Mark-MDO47/ArduinoWS2812bClock/images/LED_241_Dimensions.jpg

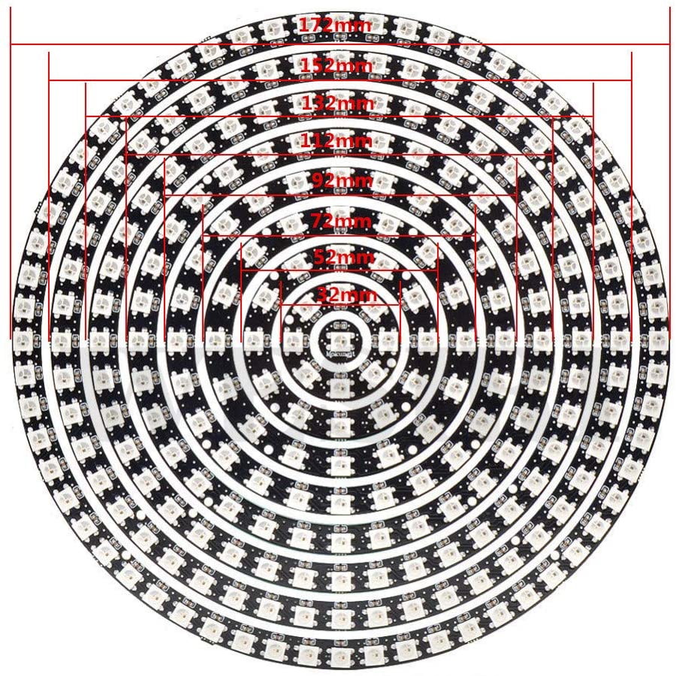
images/LED_241_Dimensions.jpg
