Mark-MDO47/ArduinoWS2812bClock/images/LED_241_busPower.jpg

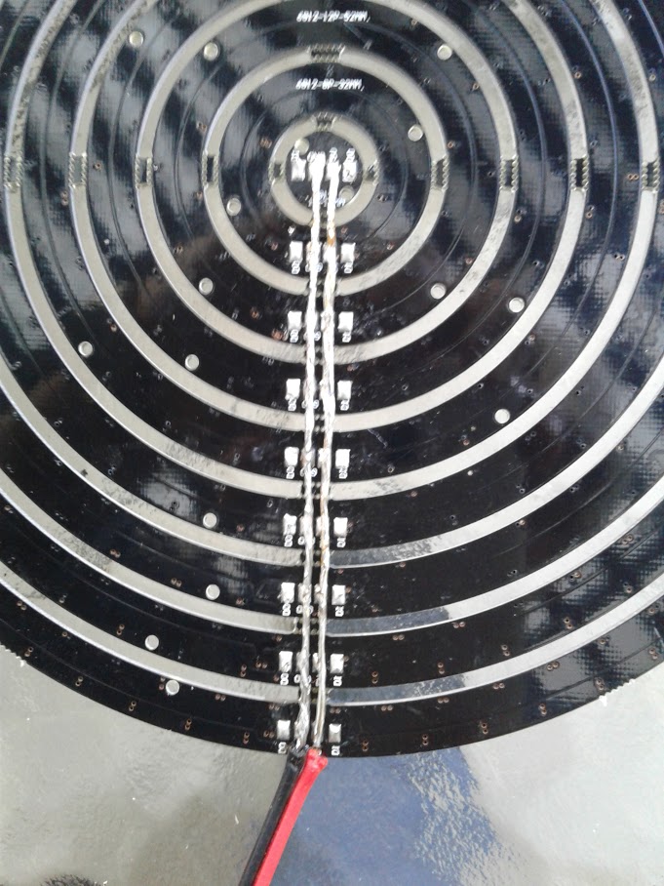
images/LED_241_busPower.jpg
