Mark-MDO47/ArduinoWS2812bClock/PartsListESP32Clock.xlsx

Sheet: PartsList
Num | CostEach | CostTotal | Description | Source | | Num | CostEach | CostTotal | Description | Source | | Ordering
Num | CostEach | CostTotal | Description | Source | | --- | --- | --- | --- | --- | | Price | Qty
1 | $29.99 | $29.99 | 241 LEDs 9 Rings WS2812B 5050 RGB LED | https://smile.amazon.com/gp/product/B083VWVP3J/ | | 1 | $29.99 | $29.99 | 241 LEDs 9 Rings WS2812B 5050 RGB LED | https://smile.amazon.com/gp/product/B083VWVP3J/ | | $29.99 | 1
1 | $5.16 | $5.16 | ESP32 ESP-32S CP2102 NodeMCU-32S ESP-WROOM-32 WiFi Unassembled | https://smile.amazon.com/gp/product/B08DQQ8CBP/ | | 1 | $5.16 | $5.16 | ESP32 ESP-32S CP2102 NodeMCU-32S ESP-WROOM-32 WiFi Unassembled | https://smile.amazon.com/gp/product/B08DQQ8CBP/ | | $25.79 | 5
0 | $6.00 | $0.00 | ESP32 ESP-32S CP2102 NodeMCU-32S ESP-WROOM-32 WiFi | https://smile.amazon.com/DORHEA-Development-Microcontroller-NodeMCU-32S-ESP-WROOM-32/dp/B086MJGFVV/ | | 0 | $6.00 | $0.00 | ESP32 ESP-32S CP2102 NodeMCU-32S ESP-WROOM-32 WiFi | https://smile.amazon.com/DORHEA-Development-Microcontroller-NodeMCU-32S-ESP-WROOM-32/dp/B086MJGFVV/ | | $17.99 | 3
1 | $0.40 | $0.40 | SN74HCT125N quadruple bus buffer and voltage translator | https://www.digikey.com/product-detail/en/texas-instruments/SN74HCT125N/296-8386-5-ND/376860 | | 1 | $0.40 | $0.40 | SN74HCT125N quadruple bus buffer and voltage translator | https://www.digikey.com/product-detail/en/texas-instruments/SN74HCT125N/296-8386-5-ND/376860 | | $0.40 | 1
1 | $4.45 | $4.45 | UBEC 3Amp | https://smile.amazon.com/2-Pieces-Hobbywing-Switch-mode-UBEC-Helicopter-Quadcopter/dp/B01GHMW0C0 | | 1 | $4.45 | $4.45 | UBEC 3Amp | https://smile.amazon.com/2-Pieces-Hobbywing-Switch-mode-UBEC-Helicopter-Quadcopter/dp/B01GHMW0C0 | | $8.90 | 2
1 | $0.10 | $0.10 | 220 Ohm resistor, 1/4 watt (optional) | https://www.digikey.com/en/products/detail/stackpole-electronics-inc/CF14JT220R/1741346 | | 1 | $0.10 | $0.10 | 220 Ohm resistor, 1/4 watt (optional) | https://www.digikey.com/en/products/detail/stackpole-electronics-inc/CF14JT220R/1741346 | | $0.10 | 1
1 | $0.10 | $0.10 | 10K Ohm resistor, 1/4 watt | https://www.digikey.com/en/products/detail/stackpole-electronics-inc/CF14JT10K0/1741265 | | 1 | $0.10 | $0.10 | 10K Ohm resistor, 1/4 watt | https://www.digikey.com/en/products/detail/stackpole-electronics-inc/CF14JT10K0/1741265 | | $0.10 | 1
1 | $0.10 | $0.10 | 0.1 uF electrolytic capacitor | https://www.digikey.com/en/products/detail/w%C3%BCrth-elektronik/860010672001/5728608 | | 1 | $0.10 | $0.10 | 0.1 uF electrolytic capacitor | https://www.digikey.com/en/products/detail/w%C3%BCrth-elektronik/860010672001/5728608 | | $0.10 | 1
1 | $0.53 | $0.53 | 100 uF electrolytic capacitor | https://www.digikey.com/en/products/detail/panasonic-electronic-components/ECA-2AM101/245067 | | 1 | $0.53 | $0.53 | 100 uF electrolytic capacitor | https://www.digikey.com/en/products/detail/panasonic-electronic-components/ECA-2AM101/245067 | | $0.53 | 1

Sheet: ByHand
 |  |  |  |  |  |  |  |  |  |  |  |  |  |  |  |  |  |  |  | 0 | 1 | 2 | 3 | 4 | 5 | 6 | 7 | 8 |  |  |  |  |  |  |  |  |  |  |  |  |  |  |  |  |  |  |  |  | 0 | 1
idx | 0 | 1 | 2 | 3 | 4 | 5 | 6 | 7 | 8 | idx | 0 | 1 | 2 | 3 | 4 | 5 | 6 | 7 | 8 | { | { | { | { | { | { | { | { | { | idx | 0 | 1 | 2 | 3 | 4 | 5 | 6 | 7 | 8 | idx | 0 | 1 | 2 | 3 | 4 | 5 | 6 | 7 | 8 | { | {
0 |  |  |  |  |  |  |  |  |  | 0 | 0 | 0 | 0 | 0 | 0 | 0 | 0 | 0 | 0 | { 0, | { 0, | { 0, | { 0, | { 0, | { 0, | { 0, | { 0, | { 0, | 0 |  |  |  |  |  |  |  |  |  | 0 | 0 | 0 | 0 | 0 | 0 | 0 | 0 | 0 | 0 | { 0, | { 0,
1 | 1 |  |  |  |  |  |  |  |  | 1 | 1 | 0 | 0 | 0 | 0 | 0 | 0 | 0 | 0 | { 0, 1, | { 0, 0, | { 0, 0, | { 0, 0, | { 0, 0, | { 0, 0, | { 0, 0, | { 0, 0, | { 0, 0, | 1 | 1 | 1 | 1 | 1 | 1 | 1 | 1 | 1 |  | 1 | 1 | 1 | 1 | 1 | 1 | 1 | 1 | 1 | 0 | { 0, 1, | { 0, 1,
2 | 1 | 1 |  |  |  |  |  |  |  | 2 | 2 | 1 | 0 | 0 | 0 | 0 | 0 | 0 | 0 | { 0, 1, 2, | { 0, 0, 1, | { 0, 0, 0, | { 0, 0, 0, | { 0, 0, 0, | { 0, 0, 0, | { 0, 0, 0, | { 0, 0, 0, | { 0, 0, 0, | 2 | 1 | 1 | 1 | 1 | 1 |  |  |  |  | 2 | 2 | 2 | 2 | 2 | 2 | 1 | 1 | 1 | 0 | { 0, 1, 2, | { 0, 1, 2,
3 | 1 | 1 | 1 |  |  |  |  |  |  | 3 | 3 | 2 | 1 | 0 | 0 | 0 | 0 | 0 | 0 | { 0, 1, 2, 3, | { 0, 0, 1, 2, | { 0, 0, 0, 1, | { 0, 0, 0, 0, | { 0, 0, 0, 0, | { 0, 0, 0, 0, | { 0, 0, 0, 0, | { 0, 0, 0, 0, | { 0, 0, 0, 0, | 3 | 1 | 1 | 1 | 1 |  |  |  |  |  | 3 | 3 | 3 | 3 | 3 | 2 | 1 | 1 | 1 | 0 | { 0, 1, 2, 3, | { 0, 1, 2, 3,
4 | 1 | 1 | 1 | 1 |  |  |  |  |  | 4 | 4 | 3 | 2 | 1 | 0 | 0 | 0 | 0 | 0 | { 0, 1, 2, 3, 4, | { 0, 0, 1, 2, 3, | { 0, 0, 0, 1, 2, | { 0, 0, 0, 0, 1, | { 0, 0, 0, 0, 0, | { 0, 0, 0, 0, 0, | { 0, 0, 0, 0, 0, | { 0, 0, 0, 0, 0, | { 0, 0, 0, 0, 0, | 4 | 1 | 1 | 1 |  |  |  |  |  |  | 4 | 4 | 4 | 4 | 3 | 2 | 1 | 1 | 1 | 0 | { 0, 1, 2, 3, 4, | { 0, 1, 2, 3, 4,
5 | 1 | 1 | 1 | 1 | 1 |  |  |  |  | 5 | 5 | 4 | 3 | 2 | 1 | 0 | 0 | 0 | 0 | { 0, 1, 2, 3, 4, 5, | { 0, 0, 1, 2, 3, 4, | { 0, 0, 0, 1, 2, 3, | { 0, 0, 0, 0, 1, 2, | { 0, 0, 0, 0, 0, 1, | { 0, 0, 0, 0, 0, 0, | { 0, 0, 0, 0, 0, 0, | { 0, 0, 0, 0, 0, 0, | { 0, 0, 0, 0, 0, 0, | 5 | 1 |  |  |  |  |  |  |  |  | 5 | 5 | 4 | 4 | 3 | 2 | 1 | 1 | 1 | 0 | { 0, 1, 2, 3, 4, 5, | { 0, 1, 2, 3, 4, 4,
6 | 1 | 1 | 1 | 1 | 1 | 1 |  |  |  | 6 | 6 | 5 | 4 | 3 | 2 | 1 | 0 | 0 | 0 | { 0, 1, 2, 3, 4, 5, 6, | { 0, 0, 1, 2, 3, 4, 5, | { 0, 0, 0, 1, 2, 3, 4, | { 0, 0, 0, 0, 1, 2, 3, | { 0, 0, 0, 0, 0, 1, 2, | { 0, 0, 0, 0, 0, 0, 1, | { 0, 0, 0, 0, 0, 0, 0, | { 0, 0, 0, 0, 0, 0, 0, | { 0, 0, 0, 0, 0, 0, 0, | 6 | 1 | 1 |  |  |  |  |  |  |  | 6 | 6 | 5 | 4 | 3 | 2 | 1 | 1 | 1 | 0 | { 0, 1, 2, 3, 4, 5, 6, | { 0, 1, 2, 3, 4, 4, 5,
7 | 1 |  |  |  |  |  |  |  |  | 7 | 7 | 5 | 4 | 3 | 2 | 1 | 0 | 0 | 0 | { 0, 1, 2, 3, 4, 5, 6, 7, | { 0, 0, 1, 2, 3, 4, 5, 5, | { 0, 0, 0, 1, 2, 3, 4, 4, | { 0, 0, 0, 0, 1, 2, 3, 3, | { 0, 0, 0, 0, 0, 1, 2, 2, | { 0, 0, 0, 0, 0, 0, 1, 1, | { 0, 0, 0, 0, 0, 0, 0, 0, | { 0, 0, 0, 0, 0, 0, 0, 0, | { 0, 0, 0, 0, 0, 0, 0, 0, | 7 | 1 | 1 | 1 | 1 | 1 | 1 |  |  |  | 7 | 7 | 6 | 5 | 4 | 3 | 2 | 1 | 1 | 0 | { 0, 1, 2, 3, 4, 5, 6, 7, | { 0, 1, 2, 3, 4, 4, 5, 6,
8 | 1 | 1 | 1 | 1 | 1 | 1 | 1 | 1 |  | 8 | 8 | 6 | 5 | 4 | 3 | 2 | 1 | 1 | 0 | { 0, 1, 2, 3, 4, 5, 6, 7, 8, | { 0, 0, 1, 2, 3, 4, 5, 5, 6, | { 0, 0, 0, 1, 2, 3, 4, 4, 5, | { 0, 0, 0, 0, 1, 2, 3, 3, 4, | { 0, 0, 0, 0, 0, 1, 2, 2, 3, | { 0, 0, 0, 0, 0, 0, 1, 1, 2, | { 0, 0, 0, 0, 0, 0, 0, 0, 1, | { 0, 0, 0, 0, 0, 0, 0, 0, 1, | { 0, 0, 0, 0, 0, 0, 0, 0, 0, | 8 | 1 |  |  |  |  |  | 1 |  |  | 8 | 8 | 6 | 5 | 4 | 3 | 2 | 2 | 1 | 0 | { 0, 1, 2, 3, 4, 5, 6, 7, 8, | { 0, 1, 2, 3, 4, 4, 5, 6, 6,
9 | 1 | 1 |  |  |  |  | 1 |  |  | 9 | 9 | 7 | 5 | 4 | 3 | 2 | 2 | 1 | 0 | { 0, 1, 2, 3, 4, 5, 6, 7, 8, 9, | { 0, 0, 1, 2, 3, 4, 5, 5, 6, 7, | { 0, 0, 0, 1, 2, 3, 4, 4, 5, 5, | { 0, 0, 0, 0, 1, 2, 3, 3, 4, 4, | { 0, 0, 0, 0, 0, 1, 2, 2, 3, 3, | { 0, 0, 0, 0, 0, 0, 1, 1, 2, 2, | { 0, 0, 0, 0, 0, 0, 0, 0, 1, 2, | { 0, 0, 0, 0, 0, 0, 0, 0, 1, 1, | { 0, 0, 0, 0, 0, 0, 0, 0, 0, 0, | 9 | 1 | 1 | 1 | 1 | 1 | 1 |  |  |  | 9 | 9 | 7 | 6 | 5 | 4 | 3 | 2 | 1 | 0 | { 0, 1, 2, 3, 4, 5, 6, 7, 8, 9, | { 0, 1, 2, 3, 4, 4, 5, 6, 6, 7,
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

Sheet: Ring Calcs
Best FastLED pin(s) to use with ESP32? | fastpin_esp32.h (https://github.com/FastLED/FastLED/blob/8ac3dd7f00e933a376530ecf86d360d167e1b82a/platforms/esp/32/fastpin_esp32.h) | https://www.reddit.com/r/FastLED/comments/gpu1fv/best_pins_to_use_with_esp32/ | Third, note that all boards are different. On the Espressif PICO-D4 boards that I favor, pin 12 seems to be used for flash boot. On my board, 13, 14, 15, 18, 19, 23, 25, 26 are all good for LEDs.
start_per_ring | leds_per_ringqrtr | leds_per_ring | factors
0 | 15 | 60 |  |  |  | 2 | 2 | 3 | 5
60 | 12 | 48 |  | 2 | 2 | 2 | 2 | 3
108 | 10 | 40 |  |  | 2 | 2 | 2 |  | 5
148 | 8 | 32 | 2 | 2 | 2 | 2 | 2 |  |  |  |  | 96
180 | 6 | 24 |  |  | 2 | 2 | 2 | 3
204 | 4 | 16 |  | 2 | 2 | 2 | 2
220 | 3 | 12 |  |  |  | 2 | 2 | 3
232 | 2 | 8 |  |  | 2 | 2 | 2
240 | 1 | 1
 |  |  |  | 1
 |  |  | 2 | 2
 |  |  | 2 | 4
 |  |  | 2 | 8
 |  |  | 2 | 16
 |  |  | 2 | 32
 |  |  | 3 | 96
 |  |  | 5 | 480 |  | #define LCM_LEDS_PER_RING 480 // they all divide into 480 evenly (least common multiple)
 |  |  | 60 | 48 | 40 | 32 | 24 | 16 | 12 | 8 | 1 |  | leds_per_ring[NUM_RINGS_PER_DISK]
 |  |  | 0 | 60 | 108 | 148 | 180 | 204 | 220 | 232 | 240 |  | start_per_ring[NUM_RINGS_PER_DISK]
 |  |  | 15 | 12 | 10 | 8 | 6 | 4 | 3 | 2 | 1 |  | leds_per_ringqrtr[NUM_RINGS_PER_DISK]

Sheet: RadarCalcs
#define NUM_LEDS_PER_DISK 241 |  |  |  |  |  |  |  |  | hour | min | angle-sec | deg
#define NUM_RINGS_PER_DISK 9 |  |  |  |  |  |  |  |  | 12 | 15 | 1 | 6
#define MAX_LEDS_PER_RING 60 |  |  |  |  |  |  |  |  | 12 | 30 | 3 | 18
#define MIN_LEDS_PER_RING 1 |  |  |  |  |  |  |  |  | 12 | 45 | 4 | 24
 |  |  |  |  |  |  |  |  | 1 | 0 | 5 | 30
 |  |  |  |  |  |  |  |  | 11 | 59 | 60 | 360
 |  |  |  |  |  |  |  |  | 12 | 0 | 0 | 0
const uint16_t leds_per_ring[NUM_RINGS_PER_DISK] = { MAX_LEDS_PER_RING, 48, 40, 32, 24, 16, 12, 8, MIN_LEDS_PER_RING }; // MAX_LEDS_PER_RING = 60
const uint16_t leds_per_ringqrtr[NUM_RINGS_PER_DISK] = { 15, 12, 10, 8, 6, 4, 3, 2, 1 };
const uint16_t start_per_ring[NUM_RINGS_PER_DISK] = { 0, 60, 108, 148, 180, 204, 220, 232, 240 }; // which LED index is the start of each ring
static int8_t this_ring = 0; // from ring_9 (value 0, outer ring) to ring_1 (value 8, inner ring (one LED))
static int8_t this_qrtr = 0; // from qrtr_1 (value 0) to qrtr_4 (value 3), count modulo in either direction
uint32_t radar_xray_bitmask[(NUM_LEDS_PER_DISK+31)/32]; // bitmask where X-Ray LEDs are for STEP2_RADAR_XRAY_SHDW1; >= one bit per LED per ring
static uint32_t bitmsk32; // used to pick out the bit in radar_xray_bitmask
static uint8_t idx_bitmsk32; // index to which array member for radar_xray_bitmask
 |  |  |  |  | ring | 0 | 1 | 2 | 3 | 4 | 5 | 6 | 7 | 8 | start_per_ring | 0 | 60 | 108 | 148 | 180 | 204 | 220 | 232 | 240
 | tmp_idx | radar_adv_per_LED_per_ring | start_per_ring | leds_per_ring | leds_per_ring | 60 | 48 | 40 | 32 | 24 | 16 | 12 | 8 | 1
 | 0 |  | 0 | 60 |  | idx_r0 | idx_r1 | idx_r2 | idx_r3 | idx_r4 | idx_r5 | idx_r6 | idx_r7 | idx_r8
 | 1 |  | 60 | 48 |  | 0 | 0 | 0 | 0 | 0 | 0 | 0 | 0 | 0
 | 2 |  | 108 | 40 |  | 1 | 1 | 1 | 1 | 0 | 0 | 0 | 0 | 0
 | 3 | 0 | 148 | 32 |  | 2 | 2 | 1 | 1 | 1 | 1 | 0 | 0 | 0
 | 4 | 192 | 180 | 24 |  | 3 | 2 | 2 | 2 | 1 | 1 | 1 | 0 | 0
 | 5 | 128 | 204 | 16 |  | 4 | 3 | 3 | 2 | 2 | 1 | 1 | 1 | 0
 | 6 | 96 | 220 | 12 |  | 5 | 4 | 3 | 3 | 2 | 1 | 1 | 1 | 0
 | 7 | 64 | 232 | 8 |  | 6 | 5 | 4 | 3 | 2 | 2 | 1 | 1 | 0
 | 8 | 0 | 240 | 1 |  | 7 | 6 | 5 | 4 | 3 | 2 | 1 | 1 | 0
 |  |  |  |  |  | 8 | 6 | 5 | 4 | 3 | 2 | 2 | 1 | 0
 |  |  |  |  |  | 9 | 7 | 6 | 5 | 4 | 2 | 2 | 1 | 0
 |  |  |  |  |  | 10 | 8 | 7 | 5 | 4 | 3 | 2 | 1 | 0
 |  |  |  |  |  | 11 | 9 | 7 | 6 | 4 | 3 | 2 | 1 | 0
 |  |  |  |  |  | 12 | 10 | 8 | 6 | 5 | 3 | 2 | 2 | 0
 |  |  |  |  |  | 13 | 10 | 9 | 7 | 5 | 3 | 3 | 2 | 0
 |  |  |  |  |  | 14 | 11 | 9 | 7 | 6 | 4 | 3 | 2 | 0
 |  |  |  |  |  | 15 | 12 | 10 | 8 | 6 | 4 | 3 | 2 | 0
 |  |  |  |  |  | 16 | 13 | 11 | 9 | 6 | 4 | 3 | 2 | 0
 |  |  |  |  |  | 17 | 14 | 11 | 9 | 7 | 5 | 3 | 2 | 0
 |  |  |  |  |  | 18 | 14 | 12 | 10 | 7 | 5 | 4 | 2 | 0
 |  |  |  |  |  | 19 | 15 | 13 | 10 | 8 | 5 | 4 | 3 | 0
 |  |  |  |  |  | 20 | 16 | 13 | 11 | 8 | 5 | 4 | 3 | 0
 |  |  |  |  |  | 21 | 17 | 14 | 11 | 8 | 6 | 4 | 3 | 0
 |  |  |  |  |  | 22 | 18 | 15 | 12 | 9 | 6 | 4 | 3 | 0
 |  |  |  |  |  | 23 | 18 | 15 | 12 | 9 | 6 | 5 | 3 | 0
 |  |  |  |  |  | 24 | 19 | 16 | 13 | 10 | 6 | 5 | 3 | 0
 |  |  |  |  |  | 25 | 20 | 17 | 13 | 10 | 7 | 5 | 3 | 0
 |  |  |  |  |  | 26 | 21 | 17 | 14 | 10 | 7 | 5 | 3 | 0
 |  |  |  |  |  | 27 | 22 | 18 | 14 | 11 | 7 | 5 | 4 | 0
 |  |  |  |  |  | 28 | 22 | 19 | 15 | 11 | 7 | 6 | 4 | 0
 |  |  |  |  |  | 29 | 23 | 19 | 15 | 12 | 8 | 6 | 4 | 0
 |  |  |  |  |  | 30 | 24 | 20 | 16 | 12 | 8 | 6 | 4 | 0
 |  |  |  |  |  | 31 | 25 | 21 | 17 | 12 | 8 | 6 | 4 | 0
 |  |  |  |  |  | 32 | 26 | 21 | 17 | 13 | 9 | 6 | 4 | 0
 |  |  |  |  |  | 33 | 26 | 22 | 18 | 13 | 9 | 7 | 4 | 0
 |  |  |  |  |  | 34 | 27 | 23 | 18 | 14 | 9 | 7 | 5 | 0
 |  |  |  |  |  | 35 | 28 | 23 | 19 | 14 | 9 | 7 | 5 | 0
 |  |  |  |  |  | 36 | 29 | 24 | 19 | 14 | 10 | 7 | 5 | 0
 |  |  |  |  |  | 37 | 30 | 25 | 20 | 15 | 10 | 7 | 5 | 0
 |  |  |  |  |  | 38 | 30 | 25 | 20 | 15 | 10 | 8 | 5 | 0
 |  |  |  |  |  | 39 | 31 | 26 | 21 | 16 | 10 | 8 | 5 | 0
 |  |  |  |  |  | 40 | 32 | 27 | 21 | 16 | 11 | 8 | 5 | 0
 |  |  |  |  |  | 41 | 33 | 27 | 22 | 16 | 11 | 8 | 5 | 0
 |  |  |  |  |  | 42 | 34 | 28 | 22 | 17 | 11 | 8 | 6 | 0
 |  |  |  |  |  | 43 | 34 | 29 | 23 | 17 | 11 | 9 | 6 | 0
 |  |  |  |  |  | 44 | 35 | 29 | 23 | 18 | 12 | 9 | 6 | 0
 |  |  |  |  |  | 45 | 36 | 30 | 24 | 18 | 12 | 9 | 6 | 0
 |  |  |  |  |  | 46 | 37 | 31 | 25 | 18 | 12 | 9 | 6 | 0
 |  |  |  |  |  | 47 | 38 | 31 | 25 | 19 | 13 | 9 | 6 | 0
 |  |  |  |  |  | 48 | 38 | 32 | 26 | 19 | 13 | 10 | 6 | 0
 |  |  |  |  |  | 49 | 39 | 33 | 26 | 20 | 13 | 10 | 7 | 0
 |  |  |  |  |  | 50 | 40 | 33 | 27 | 20 | 13 | 10 | 7 | 0
 |  |  |  |  |  | 51 | 41 | 34 | 27 | 20 | 14 | 10 | 7 | 0
 |  |  |  |  |  | 52 | 42 | 35 | 28 | 21 | 14 | 10 | 7 | 0
 |  |  |  |  |  | 53 | 42 | 35 | 28 | 21 | 14 | 11 | 7 | 0
 |  |  |  |  |  | 54 | 43 | 36 | 29 | 22 | 14 | 11 | 7 | 0
 |  |  |  |  |  | 55 | 44 | 37 | 29 | 22 | 15 | 11 | 7 | 0
 |  |  |  |  |  | 56 | 45 | 37 | 30 | 22 | 15 | 11 | 7 | 0
 |  |  |  |  |  | 57 | 46 | 38 | 30 | 23 | 15 | 11 | 0 | 0
 |  |  |  |  |  | 58 | 46 | 39 | 31 | 23 | 15 | 0 | 0 | 0
 |  |  |  |  |  | 59 | 47 | 39 | 31 | 0 | 0 | 0 | 0 | 0
 |  |  |  |  |  |  |  |  |  | delay by 1 | delay by 1 |  |  |  |  | start_per_ring | 0 | 60 | 108 | 148 | 180 | 204 | 220 | 232 | 240
 |  |  |  |  |  | idx_r0 | idx_r1 | idx_r2 | idx_r3 | idx_r4 | idx_r5 | idx_r6 | idx_r7 | idx_r8 | static uint8_t const radar_idx_ring[NUM_RINGS_PER_DISK][MAX_LEDS_PER_RING] = {
 |  |  |  |  |  | 0 | 0 | 0 | 0 | 0 | 0 | 0 | 0 | 0 |  | { 0 | { 0 | { 0 | { 0 | { 0 | { 0 | { 0 | { 0 | { 0
 |  |  |  |  |  | 1 | 1 | 1 | 1 | 0 | 0 | 0 | 0 | 0 |  | { 0, 1 | { 0, 1 | { 0, 1 | { 0, 1 | { 0, 0 | { 0, 0 | { 0, 0 | { 0, 0 | { 0, 0
 |  |  |  |  |  | 2 | 2 | 1 | 1 | 0 | 0 | 0 | 0 | 0 |  | { 0, 1, 2 | { 0, 1, 2 | { 0, 1, 1 | { 0, 1, 1 | { 0, 0, 0 | { 0, 0, 0 | { 0, 0, 0 | { 0, 0, 0 | { 0, 0, 0
 |  |  |  |  |  | 3 | 2 | 2 | 2 | 1 | 1 | 1 | 0 | 0 |  | { 0, 1, 2, 3 | { 0, 1, 2, 2 | { 0, 1, 1, 2 | { 0, 1, 1, 2 | { 0, 0, 0, 1 | { 0, 0, 0, 1 | { 0, 0, 0, 1 | { 0, 0, 0, 0 | { 0, 0, 0, 0
 |  |  |  |  |  | 4 | 3 | 3 | 2 | 1 | 1 | 1 | 1 | 0 |  | { 0, 1, 2, 3, 4 | { 0, 1, 2, 2, 3 | { 0, 1, 1, 2, 3 | { 0, 1, 1, 2, 2 | { 0, 0, 0, 1, 1 | { 0, 0, 0, 1, 1 | { 0, 0, 0, 1, 1 | { 0, 0, 0, 0, 1 | { 0, 0, 0, 0, 0
 |  |  |  |  |  | 5 | 4 | 3 | 3 | 2 | 1 | 1 | 1 | 0 |  | { 0, 1, 2, 3, 4, 5 | { 0, 1, 2, 2, 3, 4 | { 0, 1, 1, 2, 3, 3 | { 0, 1, 1, 2, 2, 3 | { 0, 0, 0, 1, 1, 2 | { 0, 0, 0, 1, 1, 1 | { 0, 0, 0, 1, 1, 1 | { 0, 0, 0, 0, 1, 1 | { 0, 0, 0, 0, 0, 0
 |  |  |  |  |  | 6 | 5 | 4 | 3 | 2 | 1 | 1 | 1 | 0 |  | { 0, 1, 2, 3, 4, 5, 6 | { 0, 1, 2, 2, 3, 4, 5 | { 0, 1, 1, 2, 3, 3, 4 | { 0, 1, 1, 2, 2, 3, 3 | { 0, 0, 0, 1, 1, 2, 2 | { 0, 0, 0, 1, 1, 1, 1 | { 0, 0, 0, 1, 1, 1, 1 | { 0, 0, 0, 0, 1, 1, 1 | { 0, 0, 0, 0, 0, 0, 0
 |  |  |  |  |  | 7 | 6 | 5 | 4 | 2 | 2 | 1 | 1 | 0 |  | { 0, 1, 2, 3, 4, 5, 6, 7 | { 0, 1, 2, 2, 3, 4, 5, 6 | { 0, 1, 1, 2, 3, 3, 4, 5 | { 0, 1, 1, 2, 2, 3, 3, 4 | { 0, 0, 0, 1, 1, 2, 2, 2 | { 0, 0, 0, 1, 1, 1, 1, 2 | { 0, 0, 0, 1, 1, 1, 1, 1 | { 0, 0, 0, 0, 1, 1, 1, 1 | { 0, 0, 0, 0, 0, 0, 0, 0
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
