Mark-MDO47/ArduinoWS2812bClock/ESP32Clock_KiCad_Wiring.pdf

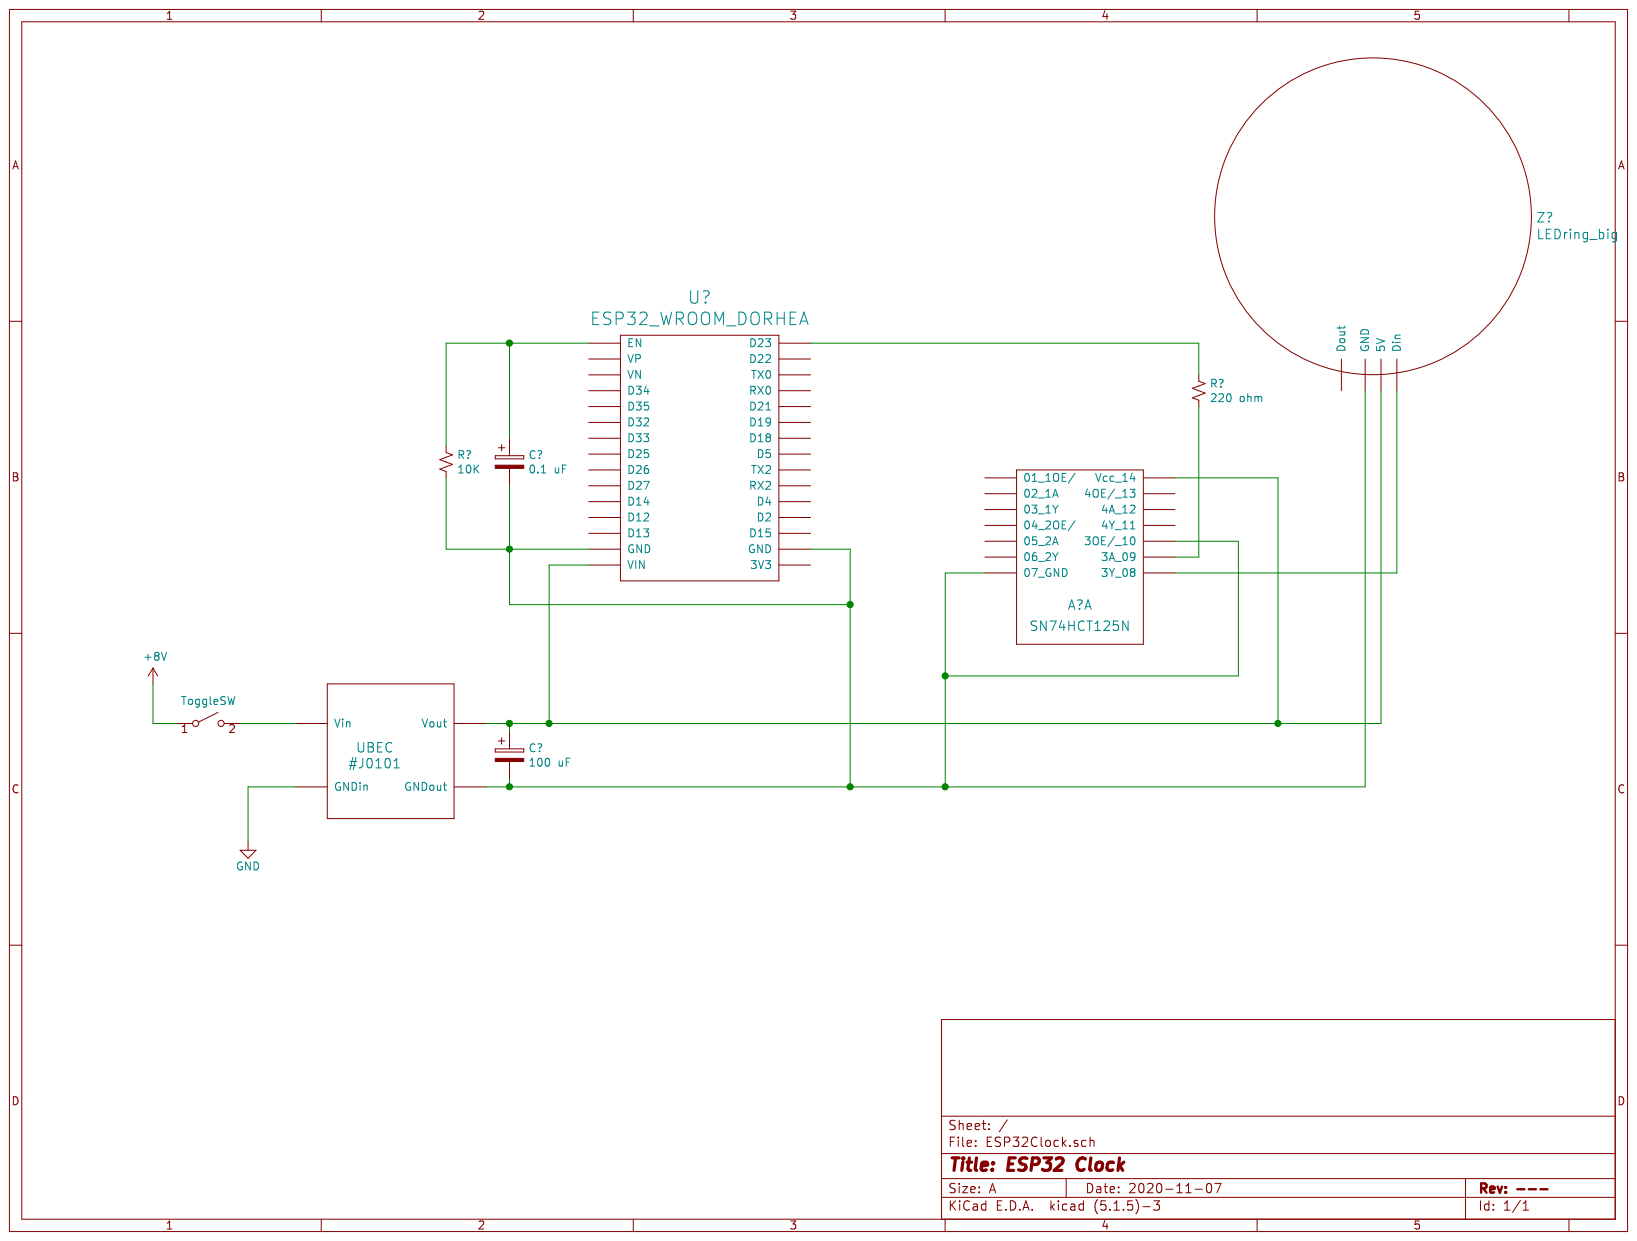
[picture p3: page 1]
