Mark-MDO47/ArduinoWS2812bClock/kicad/ESP32Clock.kicad_pcb

## KiCad design stepper_hard_limit.sch


Parts:
C1: 100n; C_Disc_D7.5mm_W5.0mm_P10.00mm
C2: 10u; CP_Radial_D10.0mm_P5.00mm
D1, D2, D3, D4, D5, D6: 1N4148; D_5W_P10.16mm_Horizontal
J1: PWR; TerminalBlock_Pheonix_MKDS1.5-2pol
J2: SW1; TerminalBlock_Pheonix_MKDS1.5-2pol
J3: SW2; TerminalBlock_Pheonix_MKDS1.5-2pol
J4: DRIVER_MOTOR; TerminalBlock_Pheonix_MKDS1.5-4pol
J5: CONTROL; TerminalBlock_Pheonix_MKDS1.5-4pol
R1, R2: 220; R_Axial_DIN0309_L9.0mm_D3.2mm_P12.70mm_Horizontal
R3, R4, R5: 1k; R_Axial_DIN0309_L9.0mm_D3.2mm_P12.70mm_Horizontal
U1: 4093; DIP-14_W7.62mm_Socket_LongPads

Connections:
+5V: C1.1, C2.1, D3.1 (K), D5.1 (K), J1.2, R3.1, R4.1, R5.1, U1.14 (Vdd)
DIR: J4.3, J5.3, U1.5, U1.8, U1.9
ENABLE: J4.4, J5.4, U1.11
GND: C1.2, C2.2, D4.2 (A), D6.2 (A), J1.1, J2.1, J3.1, J4.1, J5.1, U1.7 (Vss)
unnamed: D1.1 (K), U1.3
unnamed: D1.2 (A), D2.2 (A), R5.2, U1.12, U1.13
unnamed: D2.1 (K), U1.4
unnamed: D3.2 (A), D4.1 (K), R1.1, R3.2, U1.1
unnamed: D5.2 (A), D6.1 (K), R2.1, R4.2, U1.6
unnamed: U1.2, U1.10
STEP: J4.2, J5.2
SW1: J2.2, R1.2
SW2: J3.2, R2.2
