Mark-MDO47/ArduinoWS2812bClock/(commit log)

2020-10-30 add blank Arduino sketch
2020-10-30 move and rename Arduino code
2020-10-31 explain ESP32
2020-10-31 add driver/voltagetranslator
2020-10-31 bus buffer and voltage translator
2020-10-31 now using ESP32 not Arduino
2020-10-31 rename LED Dimension picture
2020-10-31 dimensions for LED disk
2020-11-02 First program for ESP32
2020-11-06 add parts list and computational spreadsheet
    [PartsListESP32Clock.xlsx]
2020-11-07 start adding radar effect to clock
    [PartsListESP32Clock.xlsx]
2020-11-07 KiCad style wiring diagram
    [ESP32Clock.kicad_pcb, ESP32Clock.sch, ESP32ClockWiring.sch]
2020-11-07 clean up KiCad wiring diag
    [ESP32Clock.sch]
2020-11-08 first attempt at RadarEffect()
    [PartsListESP32Clock.xlsx]
2020-11-08 combine time with prototype code
2020-11-08 Kriegsman issue 923 says can ignore #pragma message: No hardware SPI pins defined. All SPI access will default to bitbanged output
    [Esp32Clock.ino]
2020-11-08 sync LED display to tick of second hand
2020-11-08 add check_wifi_status() and a little more error checking code
    [Esp32Clock.ino]
2020-11-11 add POR circuit, debug FastLED call
    [ESP32Clock.sch]
2020-11-11 use polarized capacitors, turn off global debug prints
    [ESP32Clock.sch]
2020-11-13 more parts
    [PartsListESP32Clock.xlsx]
2020-11-13 power issues
2020-11-13 fix memcpy bug, add debug, add some parts
    [PartsListESP32Clock.xlsx]
2020-11-14 power upgrade
2020-11-14 bus power for 241 LED disk
2020-11-14 show bus power
2020-11-26 new pattern done by hand not by math, not radar, use OTA update, OTA debug
    [PartsListESP32Clock.xlsx]
